natekew/RV_condensation_controller/images/4-winds-controller-box.png

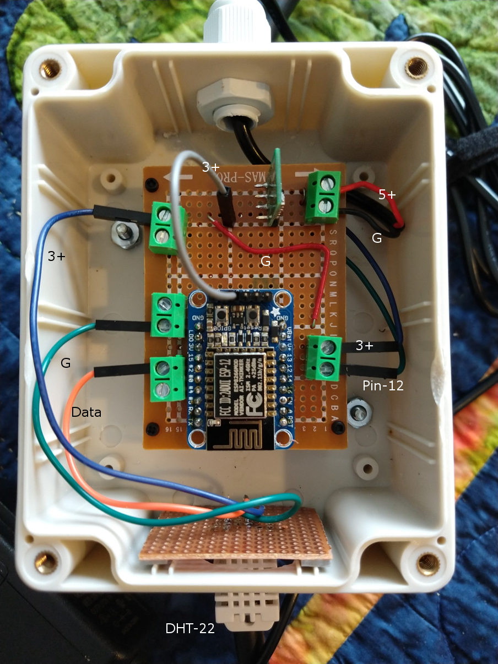
images/4-winds-controller-box.png
