natekew/RV_condensation_controller/README.md

# RV_condensation_controller
The 4-Winds Condensation Controller was initiated to curb moisture problems 
experienced while storing an RV in humid conditions.  The device uses a 
DHT-22 sensor with an ESP8266 to control a ceramic heater and provides a 
short web-based status report when requested.
R1 adds a web page to change min and max variables with post method and
also includes OTA
