natekew/RV_condensation_controller/images/Screenshot_RV_controller_Web_Page_R1.png

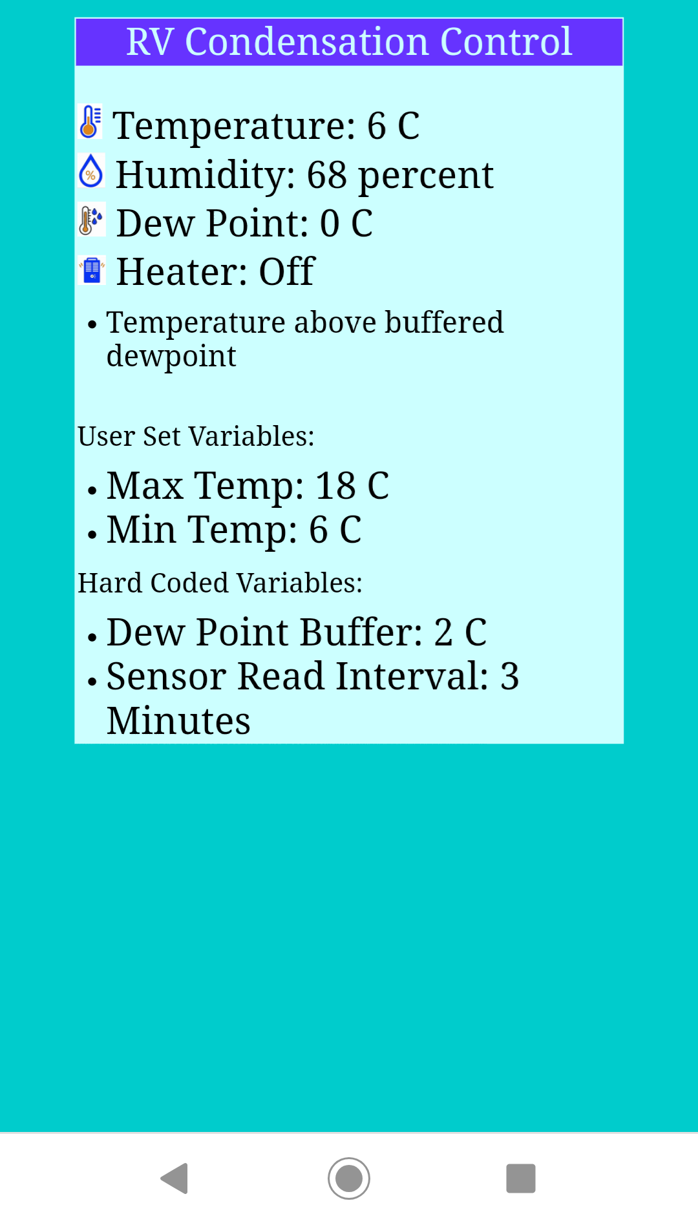
images/Screenshot_RV_controller_Web_Page_R1.png
