natekew/RV_condensation_controller/images/Screenshot_RV_Variables_Web_Page.png

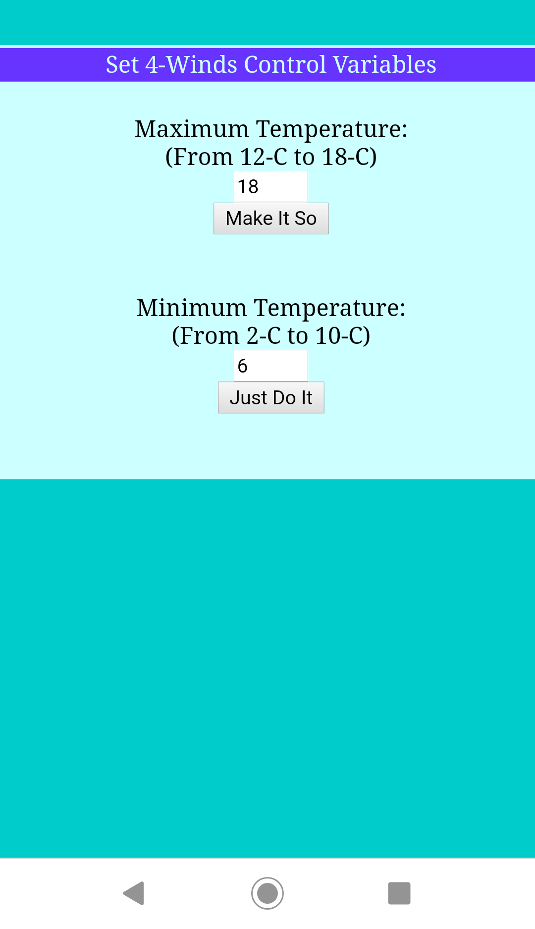
images/Screenshot_RV_Variables_Web_Page.png
